mumtez/baja_logger/(commit log)

2026-09-23 Initial commit: firmware, capture script, analysis notebook
    Add the ESP32 logger firmware, laptop-side capture script, I2C scan
    diagnostic, tap analysis notebook, project context in CLAUDE.md, and
    agent-skill config under docs/agents. Run CSVs are gitignored.
2026-09-23 Add README with project overview and bench results
    Explains the goal (fuel level from frame vibration for the Olin Baja SAE
    car), the mass-on-spring idea, the bench setup, results so far, next
    experiments, repo layout and how to run capture and the notebooks.
    Figures exported from the notebooks into docs/img.
